camstillo/Trail_Camera_v1/README.md

# Trail_Camera_v1
 Schematic and ordering information for trail camera device
