camstillo/Trail_Camera_v1/CC1200 Dev Board/Back-side PCB.PNG

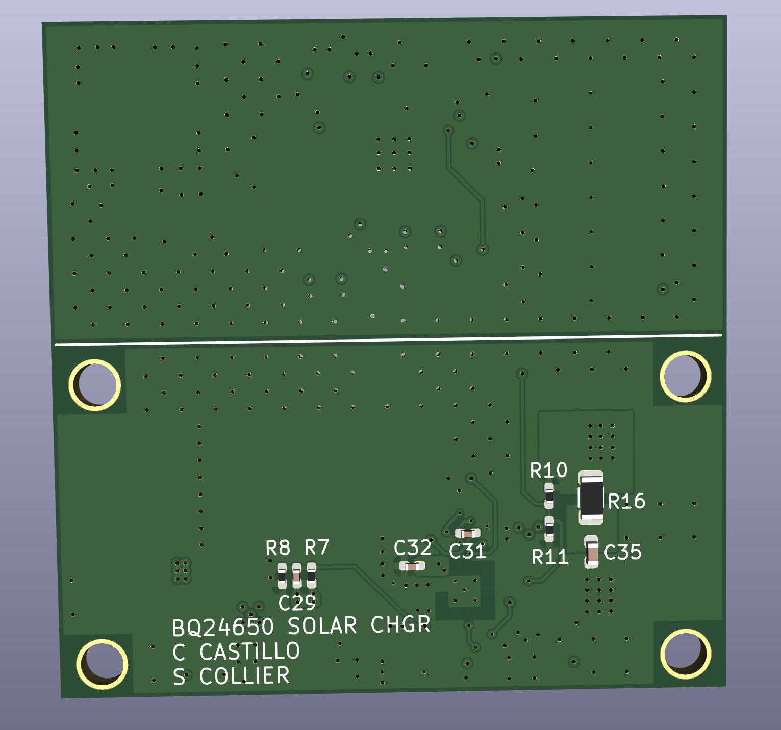
CC1200 Dev Board/Back-side PCB.PNG
