camstillo/Trail_Camera_v1/CC1200 Dev Board/Front-side PCB.PNG

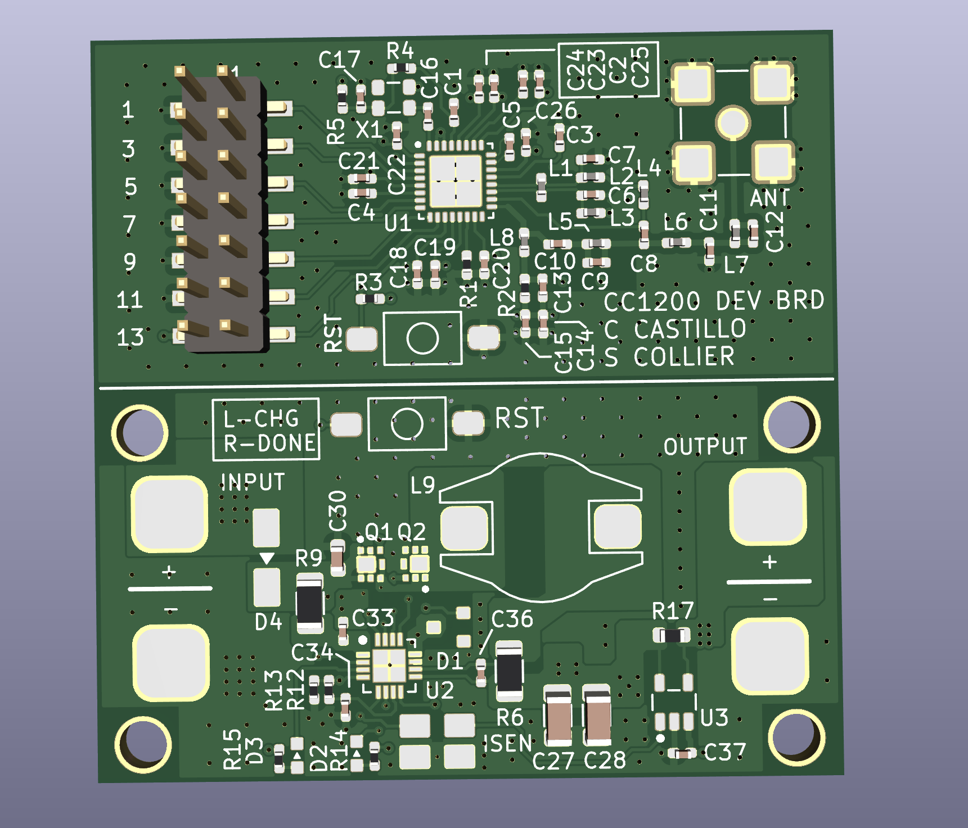
CC1200 Dev Board/Front-side PCB.PNG
