camstillo/Trail_Camera_v1/LTSpice Simulations/CC1200 Front End Model.PNG

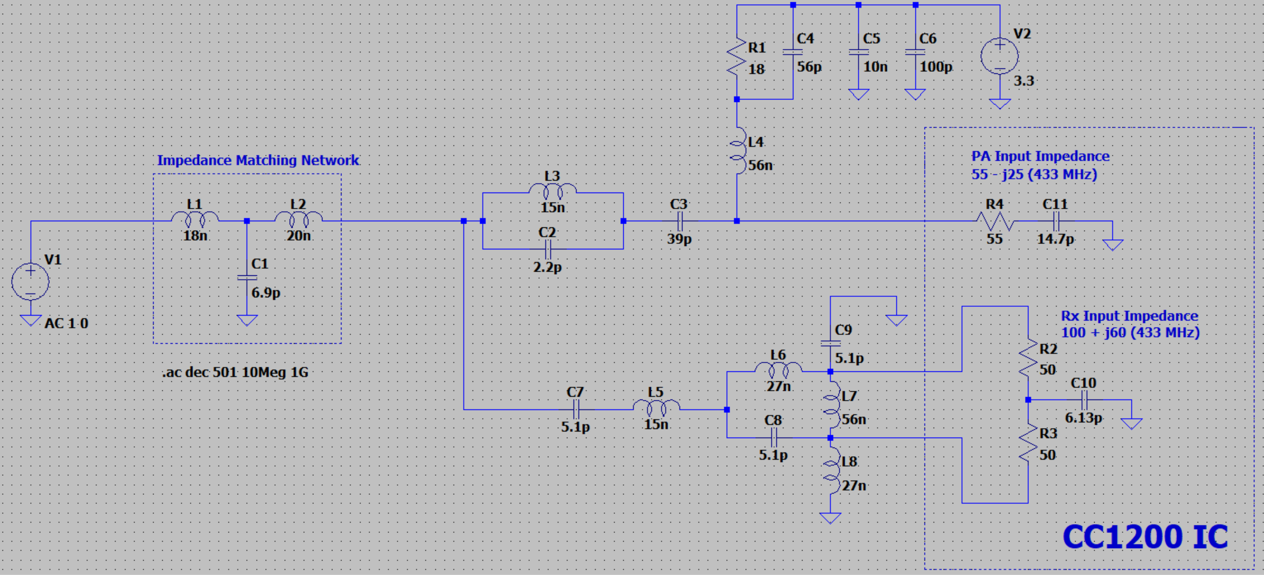
LTSpice Simulations/CC1200 Front End Model.PNG
