camstillo/Trail_Camera_v1/LTSpice Simulations/CC1200 PA Output Model.PNG

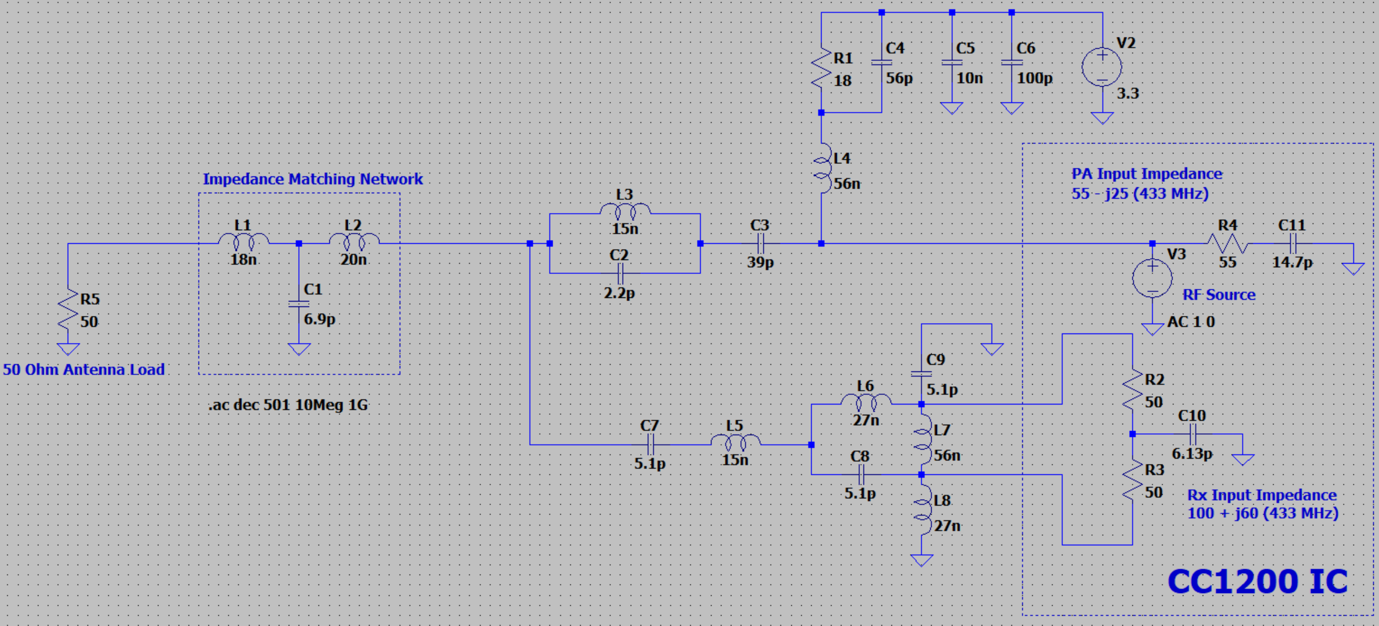
LTSpice Simulations/CC1200 PA Output Model.PNG
