camstillo/Trail_Camera_v1/LTSpice Simulations/Impedance Matching Network CC1200.PNG

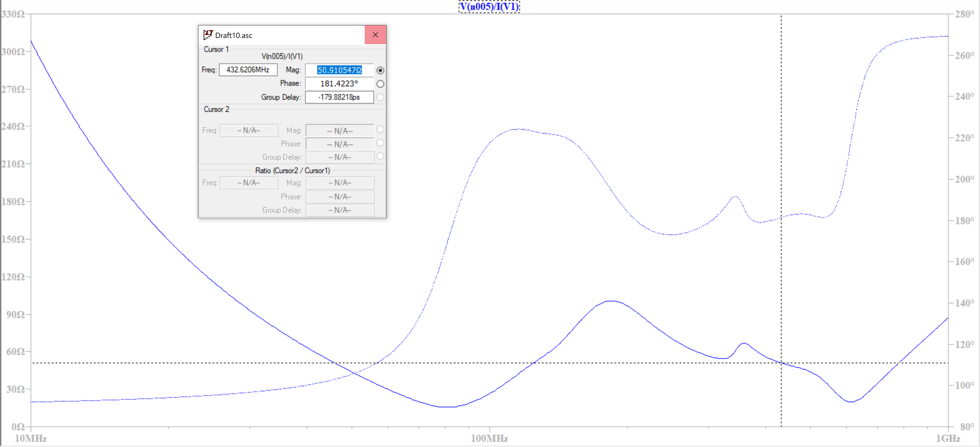
LTSpice Simulations/Impedance Matching Network CC1200.PNG
