camstillo/Trail_Camera_v1/LTSpice Simulations/Insertion loss - CC1200 Dev Board.PNG

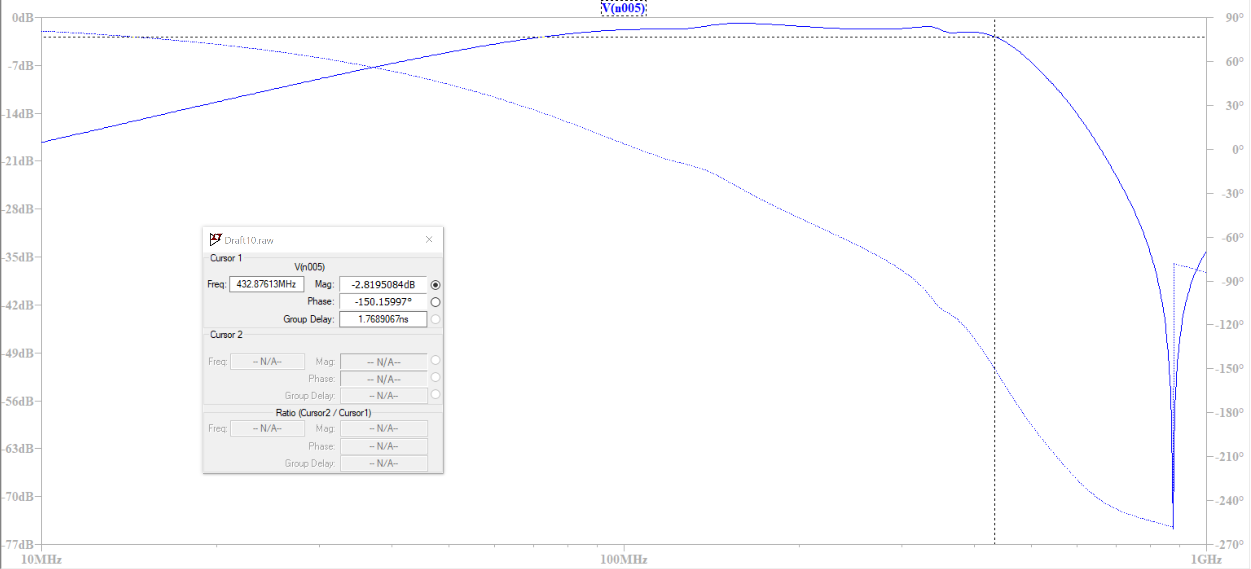
LTSpice Simulations/Insertion loss - CC1200 Dev Board.PNG
