camstillo/Trail_Camera_v1/LTSpice Simulations/CC1200 Front End Model.asc

C1: cap; 6.9p
C2: cap; 2.2p
C3: cap; 39p
C4: cap; 56p
C5: cap; 10n
C6: cap; 100p
C7: cap; 5.1p
C8: cap; 5.1p
C9: cap; 5.1p
C10: cap; 6.13p
C11: cap; 14.7p
L1: ind; 18n
L2: ind; 22n
L3: ind; 15n
L4: ind; 56n
L5: ind; 15n
L6: ind; 27n
L7: ind; 56n
L8: ind; 27n
R1: res; 18
R2: res; 50
R3: res; 50
R4: res; 55
R5: res; 50
V2: voltage; 3.3
V3: voltage; ""; AC 1 0
Named nets: 0
PA Input Impedance
55 - j25 (433 MHz)
Rx Input Impedance
100 + j60 (433 MHz)
.ac dec 501 10Meg 1G
CC1200 IC
Impedance Matching Network
50 Ohm Antenna Load
RF Source
