camstillo/Trail_Camera_v1/CC1200 Dev Board/CC1200 Dev Board.kicad_pcb

## KiCad design CC1200 Dev Board/CC1200 Dev Board.kicad_pcb (2024-01-25)

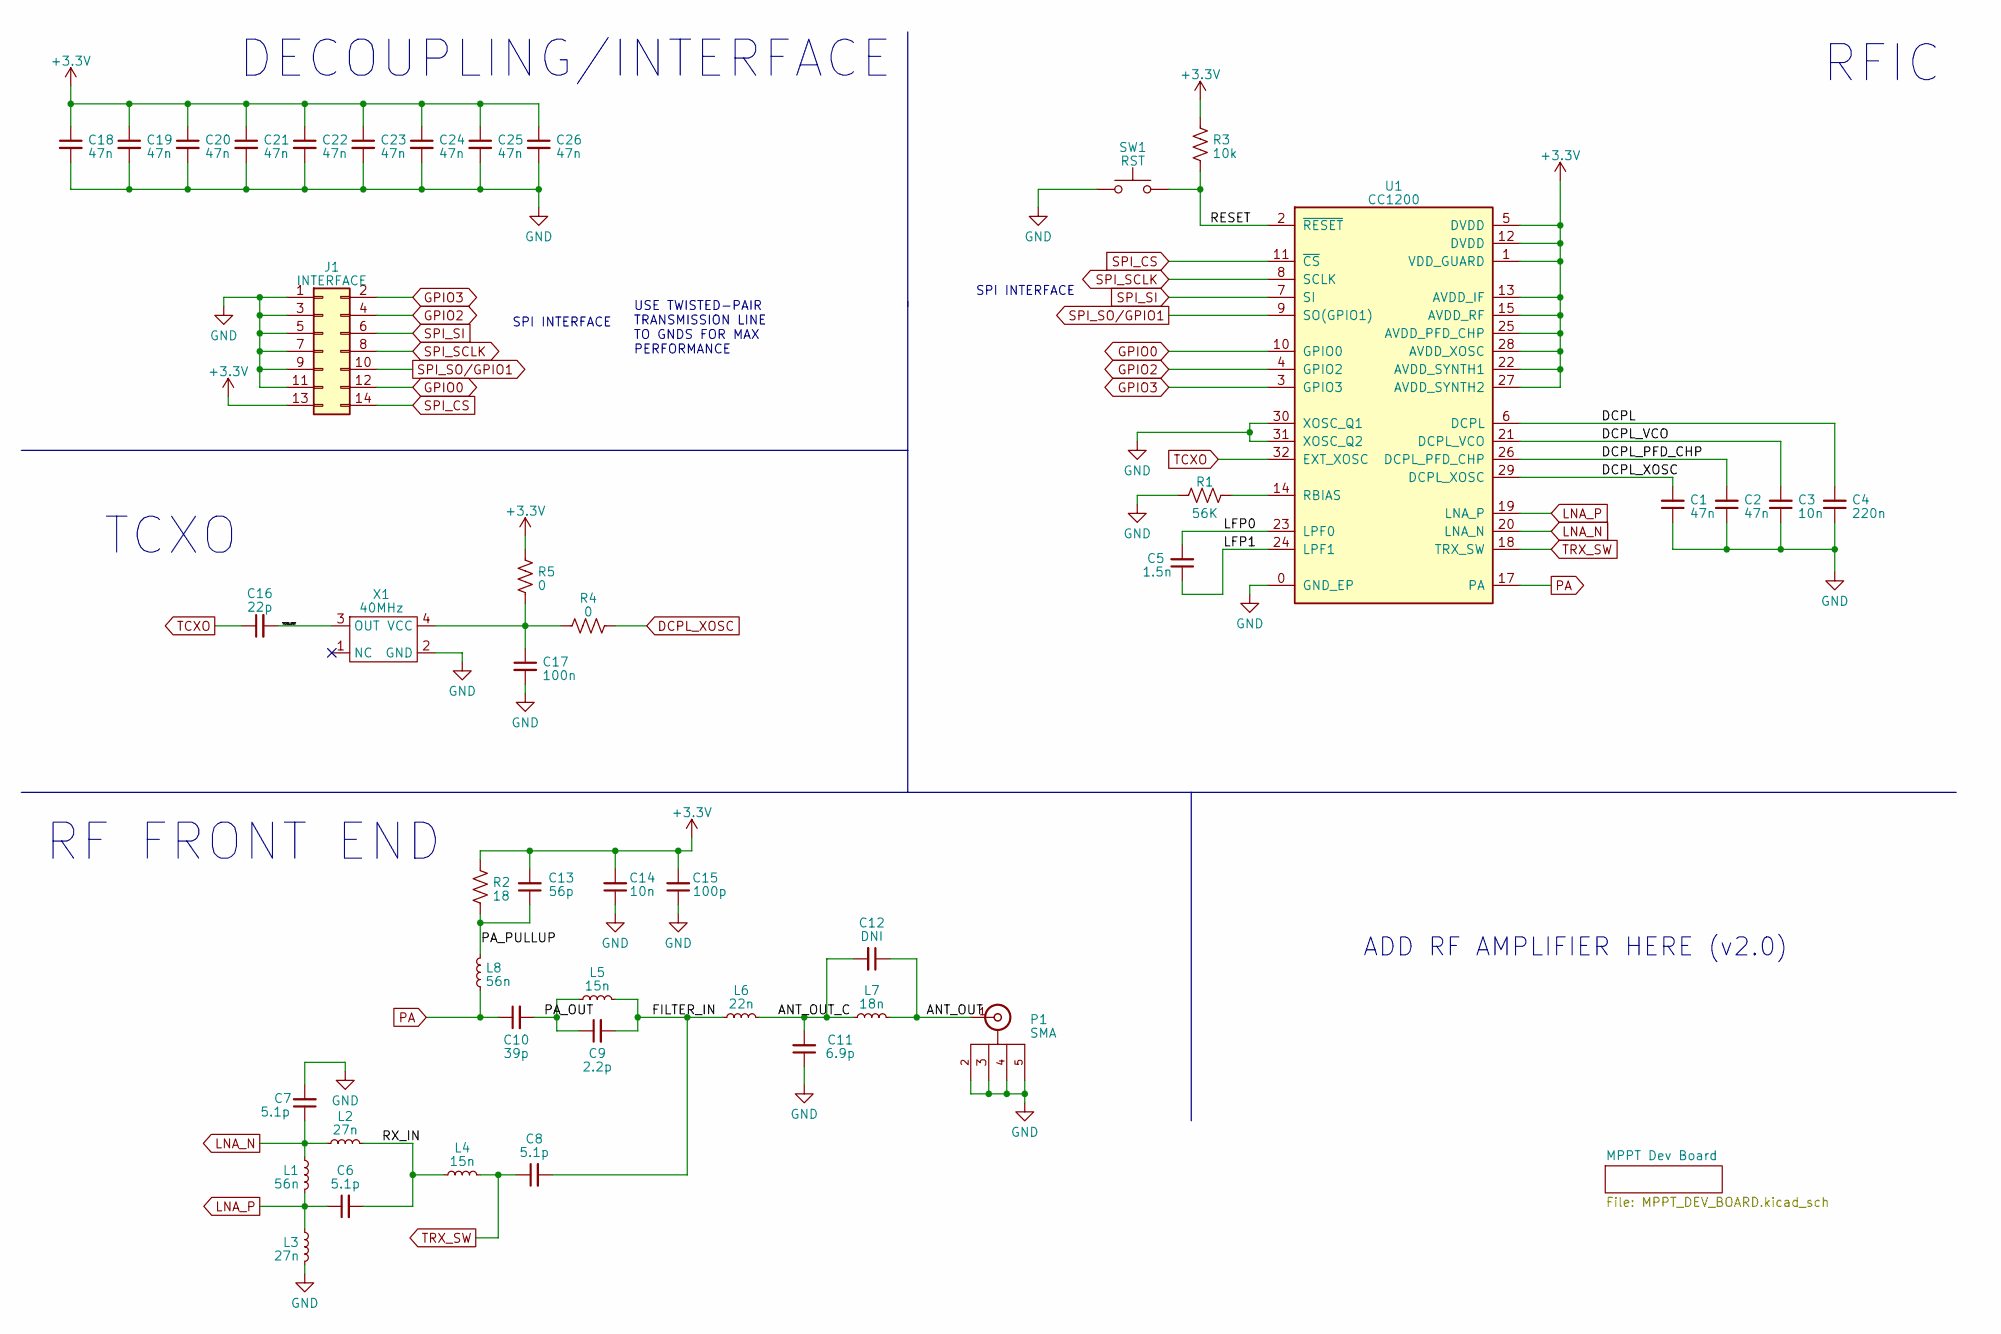
[picture p7: schematic CC1200 Dev Board.kicad_sch, CC1200 Development Board]

Parts:
C1, C2, C18, C19, C20, C21, C22, C23, C24, C25, C26: 47n; C_0402_1005Metric_Pad0.74x0.62mm_HandSolder
C3, C14: 10n; C_0402_1005Metric_Pad0.74x0.62mm_HandSolder
C4: 220n; C_0402_1005Metric_Pad0.74x0.62mm_HandSolder
C5: 1.5n; C_0402_1005Metric_Pad0.74x0.62mm_HandSolder
C6, C7, C8: 5.1p; C_0402_1005Metric_Pad0.74x0.62mm_HandSolder
C9: 2.2p; C_0402_1005Metric_Pad0.74x0.62mm_HandSolder
C10: 39p; C_0402_1005Metric_Pad0.74x0.62mm_HandSolder
C11: 6.9p; C_0402_1005Metric_Pad0.74x0.62mm_HandSolder
C12: DNI; C_0402_1005Metric_Pad0.74x0.62mm_HandSolder
C13: 56p; C_0402_1005Metric_Pad0.74x0.62mm_HandSolder
C15: 100p; C_0402_1005Metric_Pad0.74x0.62mm_HandSolder
C16: 22p; C_0402_1005Metric_Pad0.74x0.62mm_HandSolder
C17: 100n; C_0402_1005Metric_Pad0.74x0.62mm_HandSolder
J1: INTERFACE; PinHeader_2x07_P2.54mm_Vertical_SMD
L1, L8: 56n; L_0402_1005Metric_Pad0.77x0.64mm_HandSolder
L2, L3: 27n; L_0402_1005Metric_Pad0.77x0.64mm_HandSolder
L4, L5: 15n; L_0402_1005Metric_Pad0.77x0.64mm_HandSolder
L6: 22n; L_0402_1005Metric_Pad0.77x0.64mm_HandSolder
L7: 18n; L_0402_1005Metric_Pad0.77x0.64mm_HandSolder
P1: SMA; CONSMA001-SMD-G_ALT
R1: 56K; R_0402_1005Metric_Pad0.72x0.64mm_HandSolder
R2: 18; R_0402_1005Metric_Pad0.72x0.64mm_HandSolder
R3: 10k; R_0402_1005Metric_Pad0.72x0.64mm_HandSolder
R4, R5: 0; R_0402_1005Metric_Pad0.72x0.64mm_HandSolder
SW1: RST; PTS636 SL43 SMTR LFS
U1: CC1200
X1: 40MHz; TG2520SMN

Connections:
+3.3V: C13.2, C14.2, C15.2, C18.1, C19.1, C20.1, C21.1, C22.1, C23.1, C24.1, C25.1, C26.1, J1.13, R2.1, R3.1, R5.2, U1.1 (VDD_GUARD), U1.5 (DVDD), U1.12 (DVDD), U1.13 (AVDD_IF), U1.15 (AVDD_RF), U1.22 (AVDD_SYNTH1), U1.25 (AVDD_PFD_CHP), U1.27 (AVDD_SYNTH2), U1.28 (AVDD_XOSC)
/ANT_OUT: C12.1, L7.2, P1.1 (In); also elsewhere on the board
/ANT_OUT_C: C11.2, C12.2, L6.2, L7.1
/DCPL: C4.2, U1.6 (DCPL)
/DCPL_PFD_CHP: C2.2, U1.26 (DCPL_PFD_CHP)
/DCPL_VCO: C3.2, U1.21 (DCPL_VCO)
/FILTER_IN: C8.2, C9.2, L5.2, L6.1
/LFP0: C5.2, U1.23 (LPF0)
/LFP1: C5.1, U1.24 (LPF1)
/PA_OUT: C9.1, C10.2, L5.1
/PA_PULLUP: C13.1, L8.2, R2.2
/RESET: R3.2, SW1.2, U1.2 (~RESET); also elsewhere on the board
/RX_IN: C6.2, L2.2, L4.1
/TCXO_OUT: C16.2, X1.3 (OUT)
DCPL_XOSC: C1.2, R4.2, U1.29 (DCPL_XOSC)
GND: C1.1, C2.1, C3.1, C4.1, C7.2, C11.1, C14.1, C15.1, C17.2, C18.2, C19.2, C20.2, C21.2, C22.2, C23.2, C24.2, C25.2, C26.2, J1.1, J1.3, J1.5, J1.7, J1.9, J1.11, L3.2, P1.2 (Body), P1.3, P1.4, P1.5, R1.1, SW1.1, U1.0 (GND_EP), U1.30 (XOSC_Q1), U1.31 (XOSC_Q2), X1.2 (GND); also elsewhere on the board
GPIO0: J1.12, U1.10 (GPIO0)
GPIO2: J1.4, U1.4 (GPIO2)
GPIO3: J1.2, U1.3 (GPIO3)
LNA_N: C7.1, L1.1, L2.1, U1.20 (LNA_N)
LNA_P: C6.1, L1.2, L3.1, U1.19 (LNA_P)
MPPTSET_RST: SW1.2; also elsewhere on the board
unnamed: R1.2, U1.14 (RBIAS)
unnamed: C17.1, R4.1, R5.1, X1.4 (VCC)
PA: C10.1, L8.1, U1.17 (PA)
SPI_CS: J1.14, U1.11 (~CS)
SPI_SCLK: J1.8, U1.8 (SCLK)
SPI_SI: J1.6, U1.7 (SI)
SPI_SO/GPIO1: J1.10, U1.9 (SO(GPIO1))
TCXO: C16.1, U1.32 (EXT_XOSC)
TRX_SW: C8.1, L4.2, U1.18 (TRX_SW)

Notes on the sheet:
RFIC
TCXO
RF FRONT END
ADD RF AMPLIFIER HERE (v2.0)
DECOUPLING/INTERFACE
USE TWISTED-PAIR TRANSMISSION LINE TO GNDS FOR MAX PERFORMANCE
SPI INTERFACE

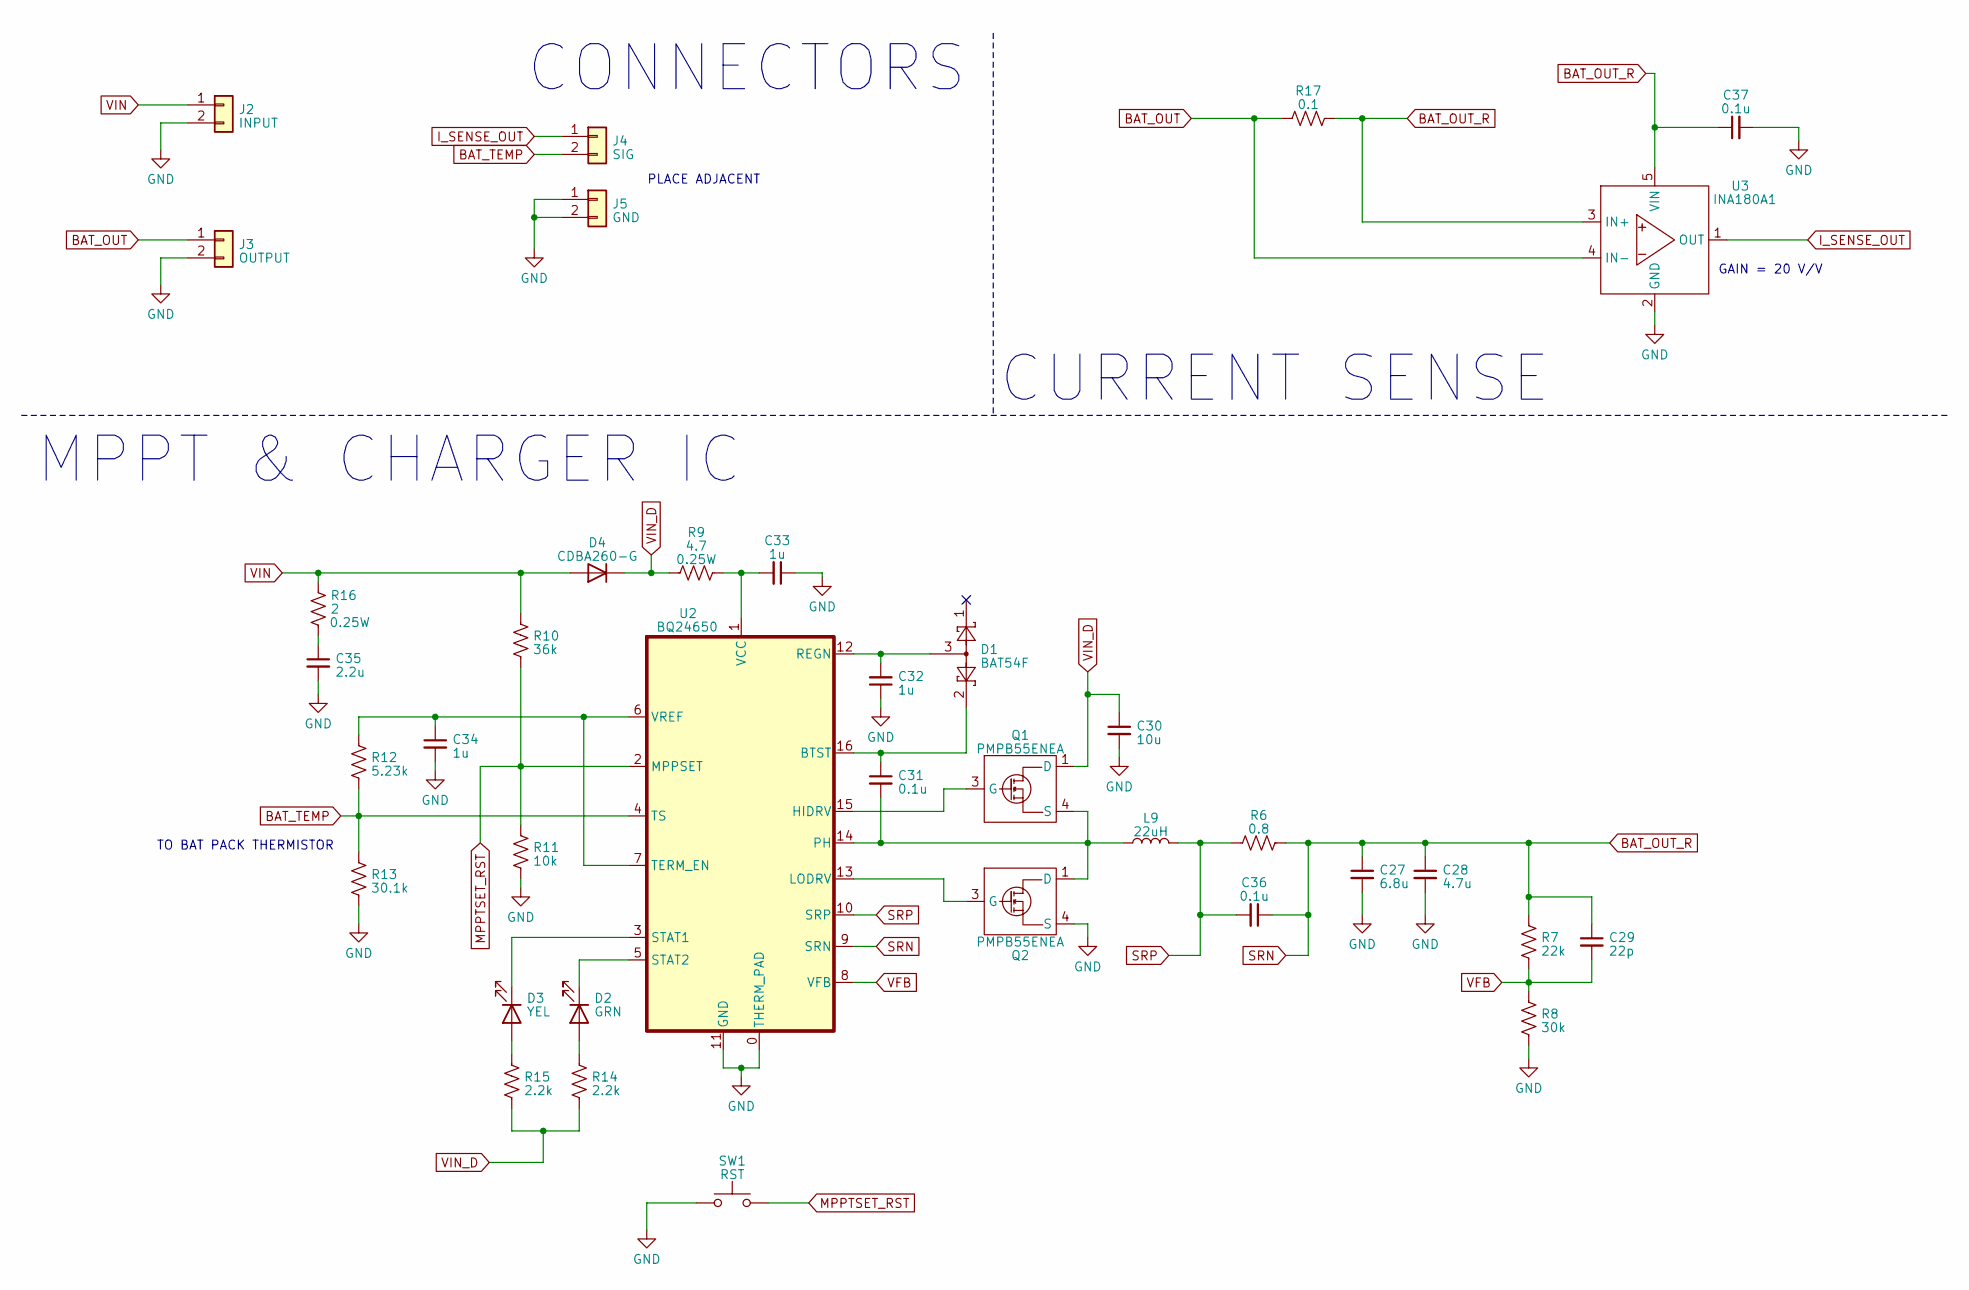
[picture p8: schematic MPPT_DEV_BOARD.kicad_sch, BQ24650 Development Board]

Parts:
C27: 6.8u; C_1206_3216Metric
C28: 4.7u; C_1206_3216Metric
C29: 22p; C_0402_1005Metric_Pad0.74x0.62mm_HandSolder
C30: 10u; C_0603_1608Metric
C31, C36, C37: 0.1u; C_0402_1005Metric_Pad0.74x0.62mm_HandSolder
C32, C33, C34: 1u; C_0402_1005Metric_Pad0.74x0.62mm_HandSolder
C35: 2.2u; C_0603_1608Metric
D1: BAT54F; BAT54-7-F
D2: GRN; MSAST105SB5104KFNA01
D3: YEL; MSAST105SB5104KFNA01
D4: CDBA260-G
J2: INPUT; InOut_Pads
J3: OUTPUT; InOut_Pads
J4: SIG; InOut_Pads
J5: GND; InOut_Pads
L9: 22uH; SRR1005-220Y
Q1, Q2: PMPB55ENEA
R6: 0.8; R_1206_3216Metric
R7: 22k; R_0402_1005Metric_Pad0.72x0.64mm_HandSolder
R8: 30k; R_0402_1005Metric_Pad0.72x0.64mm_HandSolder
R9: 4.7; R_1206_3216Metric
R10: 36k; R_0402_1005Metric_Pad0.72x0.64mm_HandSolder
R11: 10k; R_0402_1005Metric_Pad0.72x0.64mm_HandSolder
R12: 5.23k; R_0402_1005Metric_Pad0.72x0.64mm_HandSolder
R13: 30.1k; R_0402_1005Metric_Pad0.72x0.64mm_HandSolder
R14, R15: 2.2k; R_0402_1005Metric_Pad0.72x0.64mm_HandSolder
R16: 2; R_1206_3216Metric
R17: 0.1; R_0603_1608Metric
SW1: RST; PTS636 SL43 SMTR LFS
U2: BQ24650
U3: INA180A1; INA180A1IDBVR

Connections:
/RESET: SW1.2; also elsewhere on the board
BAT_OUT: J3.1, R17.1, U3.4 (IN-)
BAT_OUT_R: C27.1, C28.1, C29.1, C36.1, C37.1, R6.2, R7.2, R17.2, U2.9 (SRN), U3.3 (IN+), U3.5 (VIN)
BAT_TEMP: J4.2, R12.1, R13.2, U2.4 (TS)
GND: C27.2, C28.2, C30.2, C32.1, C33.1, C34.2, C35.2, C37.2, J2.2, J3.2, J5.1, J5.2, Q2.4 (S), Q2.8 (S), R8.1, R11.1, R13.1, SW1.1, U2.0 (THERM_PAD), U2.11 (GND), U3.2 (GND); also elsewhere on the board
I_SENSE_OUT: J4.1, U3.1 (OUT)
MPPTSET_RST: R10.1, R11.2, SW1.2, U2.2 (MPPSET); also elsewhere on the board
unnamed: C35.1, R16.1
unnamed: D2.2 (A), R14.2
unnamed: D2.1 (K), U2.5 (STAT2)
unnamed: D3.2 (A), R15.2
unnamed: D3.1 (K), U2.3 (STAT1)
unnamed: Q1.3 (G), U2.15 (HIDRV)
unnamed: Q2.3 (G), U2.13 (LODRV)
unnamed: C31.1, D1.2, U2.16 (BTST)
unnamed: C31.2, L9.1, Q1.4 (S), Q1.8 (S), Q2.1 (D), Q2.2 (D), Q2.5 (D), Q2.6 (D), Q2.7 (D), U2.14 (PH)
unnamed: C32.2, D1.3, U2.12 (REGN)
unnamed: C34.1, R12.2, U2.6 (VREF), U2.7 (TERM_EN)
unnamed: C33.2, R9.2, U2.1 (VCC)
SRP: C36.2, L9.2, R6.1, U2.10 (SRP)
VFB: C29.2, R7.1, R8.2, U2.8 (VFB)
VIN: D4.2 (A), J2.1, R10.2, R16.2
VIN_D: C30.1, D4.1 (K), Q1.1 (D), Q1.2 (D), Q1.5 (D), Q1.6 (D), Q1.7 (D), R9.1, R14.1, R15.1

Notes on the sheet:
MPPT & CHARGER IC
PLACE ADJACENT
GAIN = 20 V/V
CURRENT SENSE
CONNECTORS
TO BAT PACK THERMISTOR

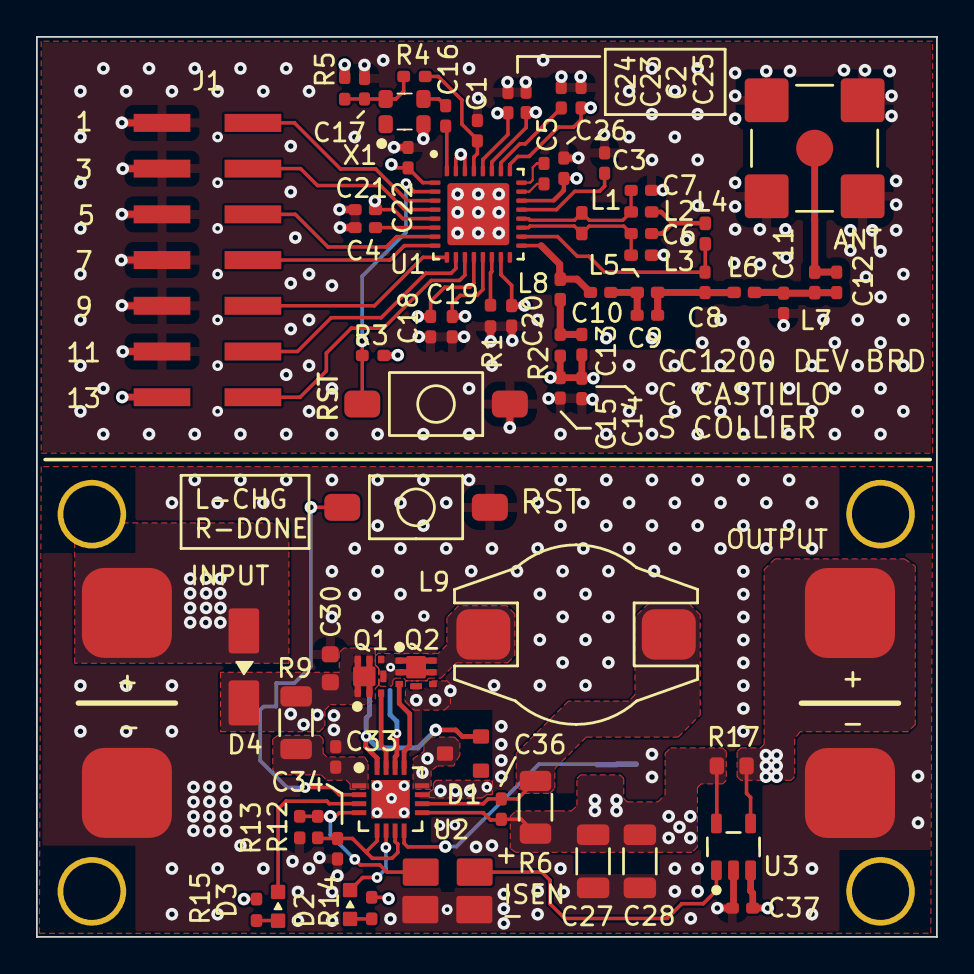
[picture p9: board CC1200 Dev Board.kicad_pcb from above]

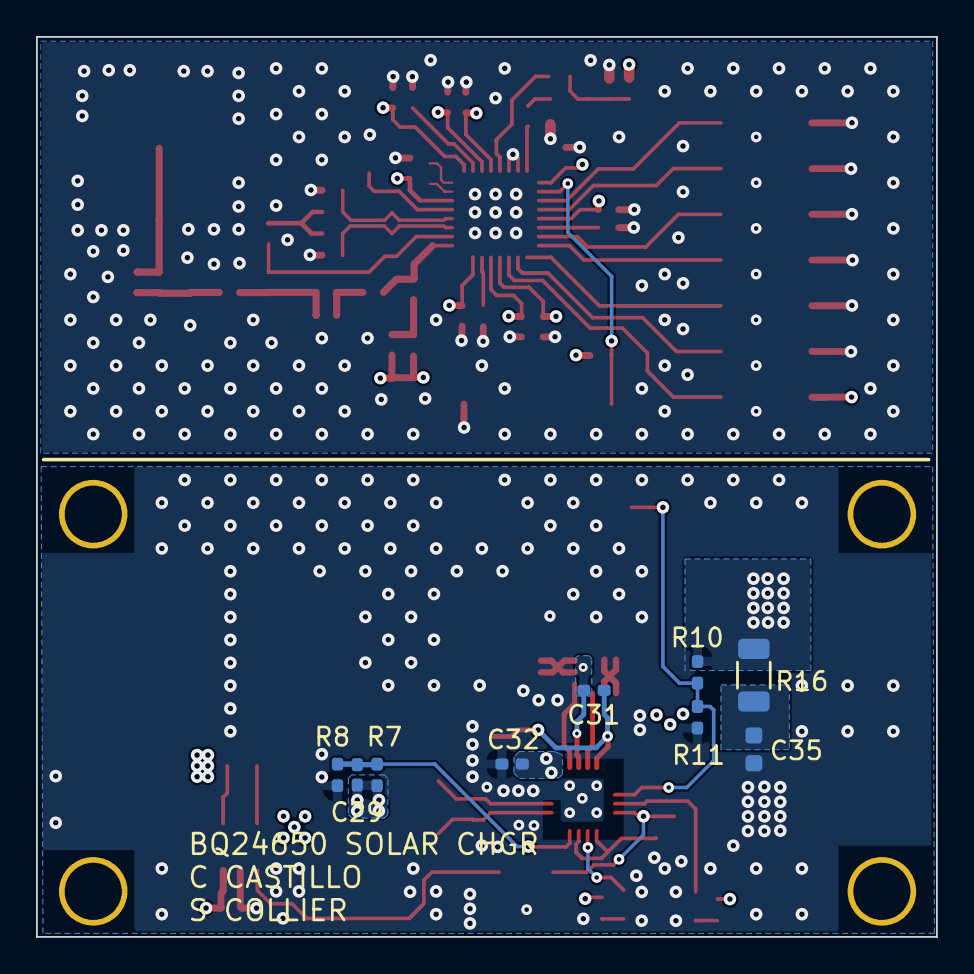
[picture p10: board CC1200 Dev Board.kicad_pcb from below]

Board: 4 copper layers, 50.0 x 50.0 mm, 81 parts (9 on the bottom side), 51 nets.

Other parts of the board:
ANT: SMA; CONSMA001-SMD-G_ALT
RST: RST; PTS636 SL43 SMTR LFS
RST#2: RST; PTS636 SL43 SMTR LFS

Their connections:
/ANT_OUT: ANT.1 (In); also elsewhere on the board
/RESET: RST#2.2; also elsewhere on the board
GND: ANT.2 (Body), ANT.3, ANT.4, ANT.5, RST.1, RST#2.1; also elsewhere on the board
MPPTSET_RST: RST.2; also elsewhere on the board
