camstillo/Trail_Camera_v1/(commit log)

2024-01-25 Added all schematic files
    [CC1200 Dev Board - Copy.csv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]
2024-01-31 Added and cut some gerbers
